Lukman-Rizvi/iot-predictive-maintenance/file/img1.jpeg

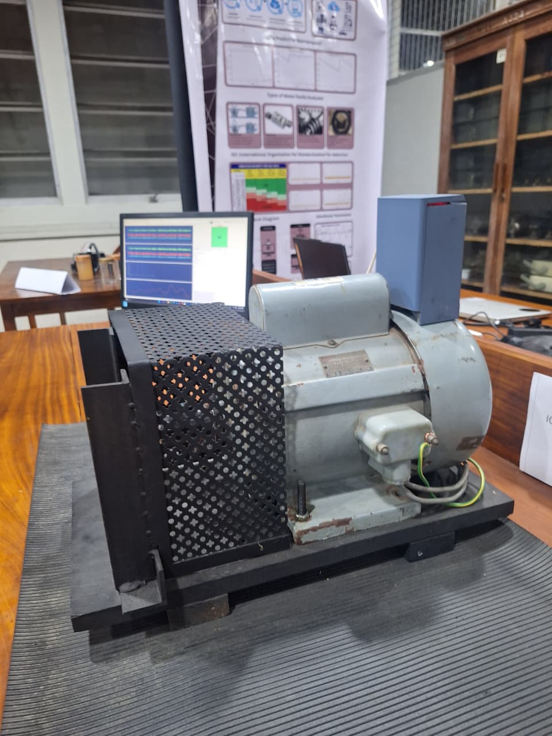
file/img1.jpeg
