Lukman-Rizvi/iot-predictive-maintenance/file/img2.jpeg

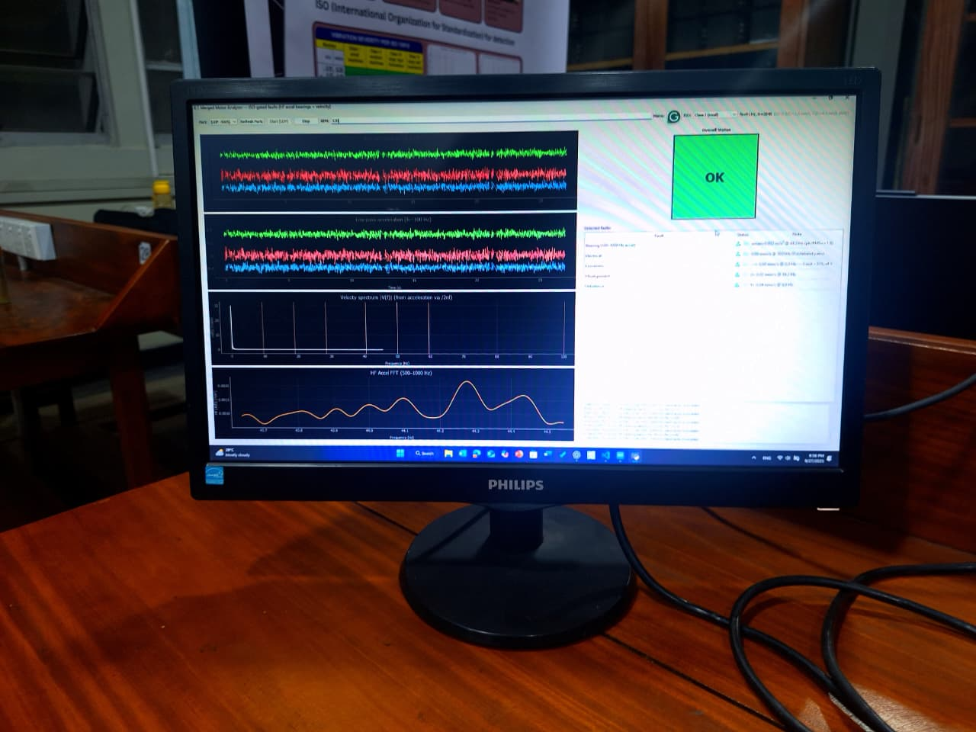
file/img2.jpeg
