Lukman-Rizvi/iot-predictive-maintenance/file/img3.jpeg

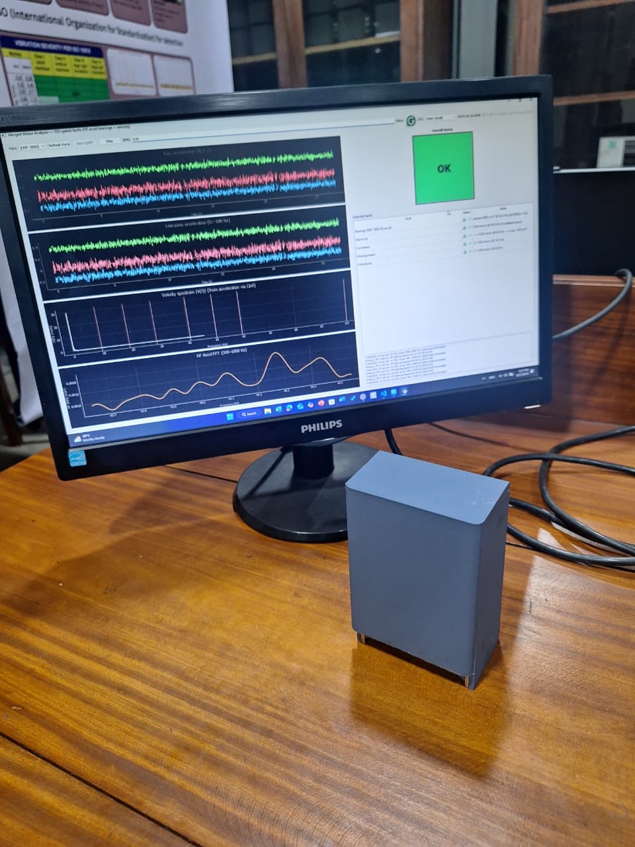
file/img3.jpeg
