Lukman-Rizvi/iot-predictive-maintenance/file/img4.jpeg

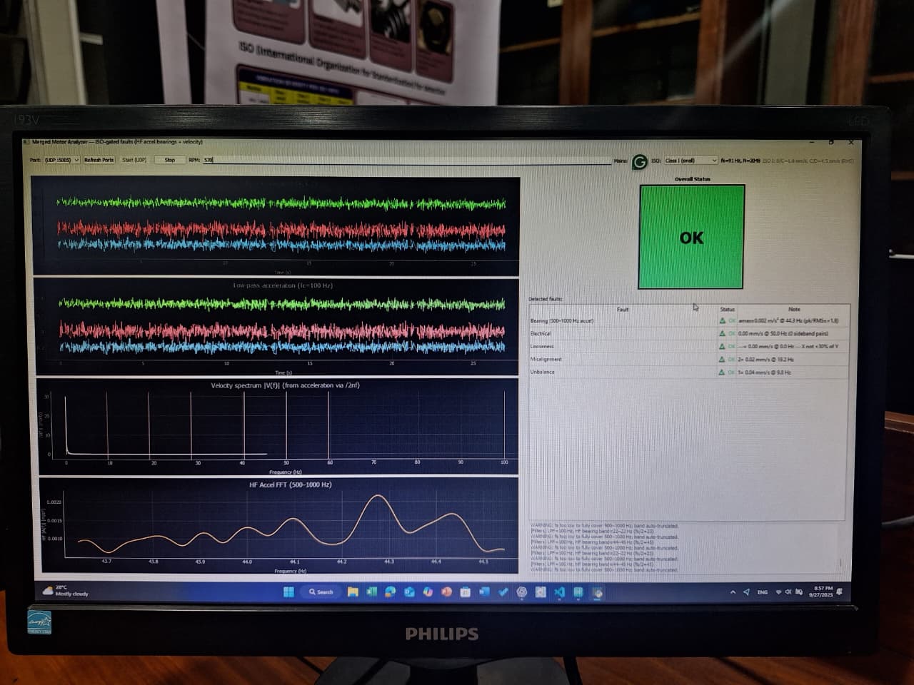
file/img4.jpeg
