Lukman-Rizvi/iot-predictive-maintenance/file/img5.jpeg

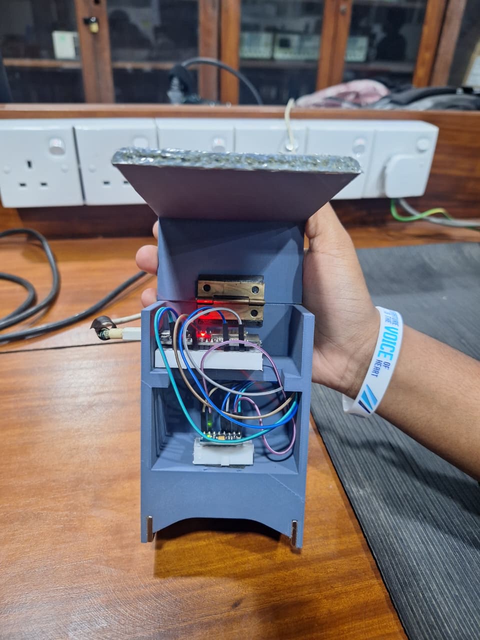
file/img5.jpeg
