Lukman-Rizvi/iot-predictive-maintenance/hardware/wiring_diagram.jpeg

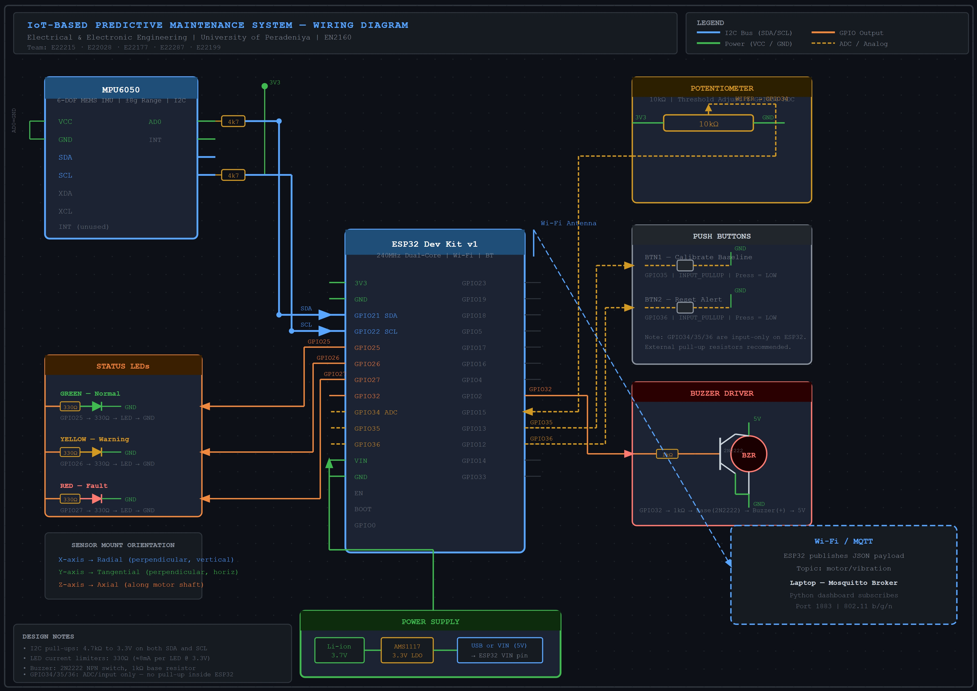
hardware/wiring_diagram.jpeg
