Lukman-Rizvi/iot-predictive-maintenance/results/fault_test_results.csv

timestamp | phase | motor_rpm | ax_rms | ay_rms | az_rms | threshold | fault_status | uptime_s
14:00:00.000 | healthy_baseline | 200 | 0.0888 | 0.069 | 0.0594 | 0.2 | OK | 0
14:00:00.250 | healthy_baseline | 200 | 0.0956 | 0.0692 | 0.0525 | 0.2 | OK | 0
14:00:00.500 | healthy_baseline | 200 | 0.0927 | 0.0684 | 0.0589 | 0.2 | OK | 0
14:00:00.750 | healthy_baseline | 200 | 0.0909 | 0.0714 | 0.0658 | 0.2 | OK | 0
14:00:01.000 | healthy_baseline | 200 | 0.0953 | 0.0707 | 0.0563 | 0.2 | OK | 1
14:00:01.250 | healthy_baseline | 200 | 0.0819 | 0.0715 | 0.0666 | 0.2 | OK | 1
14:00:01.500 | healthy_baseline | 200 | 0.0903 | 0.0694 | 0.0627 | 0.2 | OK | 1
14:00:01.750 | healthy_baseline | 200 | 0.0784 | 0.0681 | 0.0625 | 0.2 | OK | 1
14:00:02.000 | healthy_baseline | 200 | 0.097 | 0.0686 | 0.0619 | 0.2 | OK | 2
14:00:02.250 | healthy_baseline | 200 | 0.092 | 0.0747 | 0.0544 | 0.2 | OK | 2
14:00:02.500 | healthy_baseline | 200 | 0.0945 | 0.0609 | 0.0469 | 0.2 | OK | 2
14:00:02.750 | healthy_baseline | 200 | 0.0851 | 0.0645 | 0.0644 | 0.2 | OK | 2
14:00:03.000 | healthy_baseline | 200 | 0.0953 | 0.0627 | 0.0642 | 0.2 | OK | 3
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
