Lukman-Rizvi/iot-predictive-maintenance/results/baseline_rms.csv

timestamp | ax_rms | ay_rms | az_rms | threshold | fault_status | uptime_s
14:00:00.000 | 0.0861 | 0.0723 | 0.0616 | 0.2 | OK | 0
14:00:00.250 | 0.0948 | 0.0703 | 0.0562 | 0.2 | OK | 0
14:00:00.500 | 0.0821 | 0.0761 | 0.0485 | 0.2 | OK | 0
14:00:00.750 | 0.086 | 0.0637 | 0.0604 | 0.2 | OK | 0
14:00:01.000 | 0.0863 | 0.0673 | 0.064 | 0.2 | OK | 1
14:00:01.250 | 0.0861 | 0.0631 | 0.0649 | 0.2 | OK | 1
14:00:01.500 | 0.0959 | 0.0772 | 0.0627 | 0.2 | OK | 1
14:00:01.750 | 0.0848 | 0.077 | 0.058 | 0.2 | OK | 1
14:00:02.000 | 0.0912 | 0.0633 | 0.0568 | 0.2 | OK | 2
14:00:02.250 | 0.0932 | 0.074 | 0.0602 | 0.2 | OK | 2
14:00:02.500 | 0.0986 | 0.0695 | 0.0496 | 0.2 | OK | 2
14:00:02.750 | 0.0935 | 0.057 | 0.0516 | 0.2 | OK | 2
14:00:03.000 | 0.0869 | 0.0733 | 0.0626 | 0.2 | OK | 3
14:00:03.250 | 0.088 | 0.0721 | 0.0535 | 0.2 | OK | 3
14:00:03.500 | 0.1067 | 0.0685 | 0.0593 | 0.2 | OK | 3
14:00:03.750 | 0.0884 | 0.0767 | 0.0608 | 0.2 | OK | 3
14:00:04.000 | 0.0912 | 0.0678 | 0.0581 | 0.2 | OK | 4
14:00:04.250 | 0.0913 | 0.0698 | 0.0605 | 0.2 | OK | 4
14:00:04.500 | 0.0859 | 0.0764 | 0.0627 | 0.2 | OK | 4
14:00:04.750 | 0.1017 | 0.0739 | 0.0612 | 0.2 | OK | 4
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
